RASM80/simple_DAB/(list of files, drawings)

Other design files:
hardware/schematics/circuitry.pdsprj
